tianBreznik/izbrisani/deploy/desk-pi/wscase-ref/wscase-concept-front.png

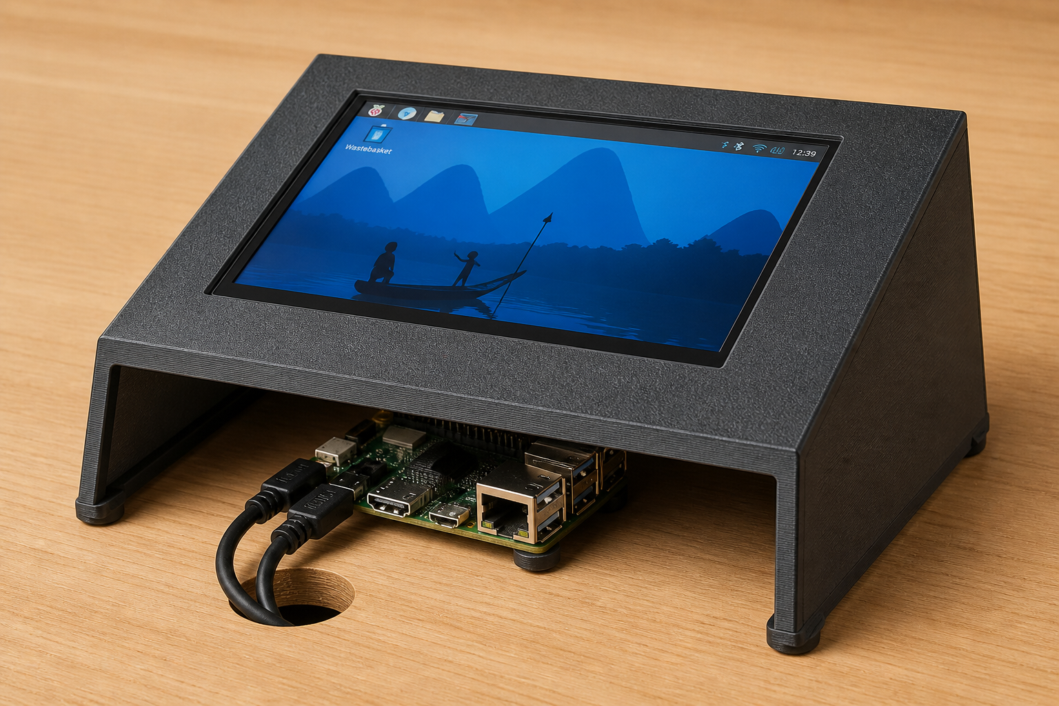
deploy/desk-pi/wscase-ref/wscase-concept-front.png
