tianBreznik/izbrisani/tmp/wscase/ext_measure.png

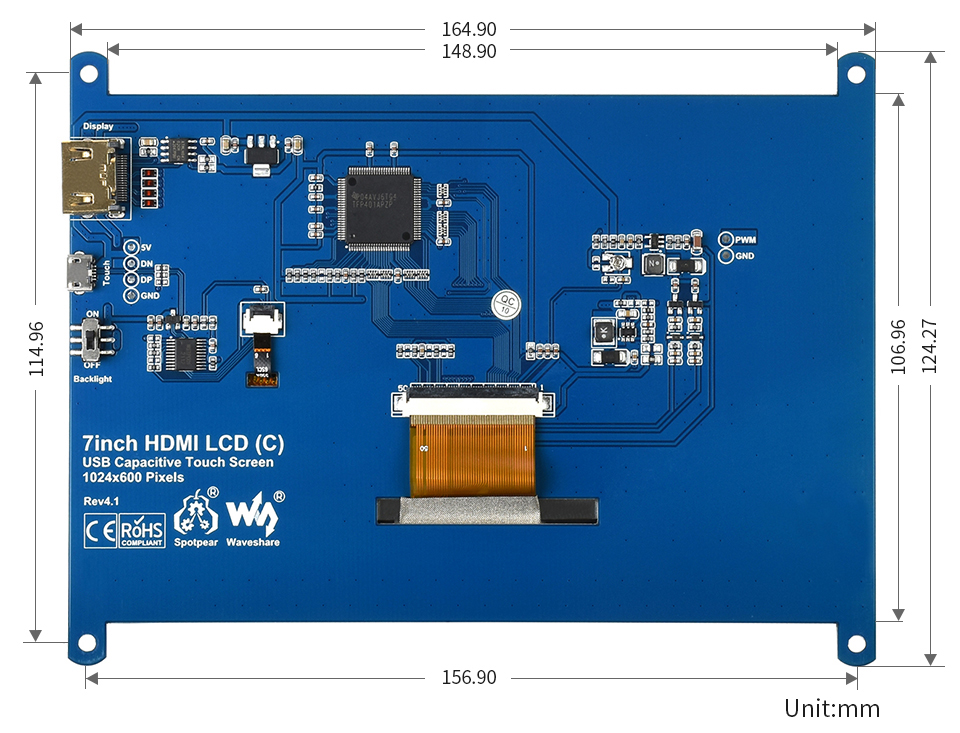
tmp/wscase/ext_measure.png
