tianBreznik/izbrisani/deploy/desk-pi/wscase-ref/wscase-concept-cutaway.png

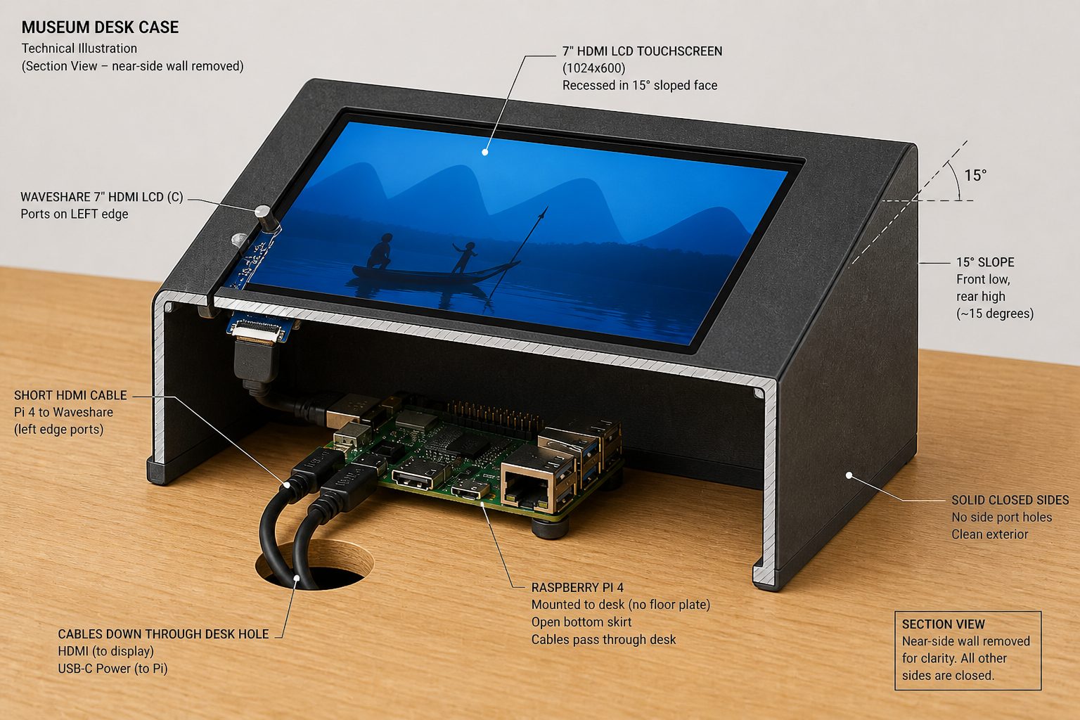
deploy/desk-pi/wscase-ref/wscase-concept-cutaway.png
