tianBreznik/izbrisani/deploy/desk-pi/wscase-ref/wscase-corner-pad-explain.png

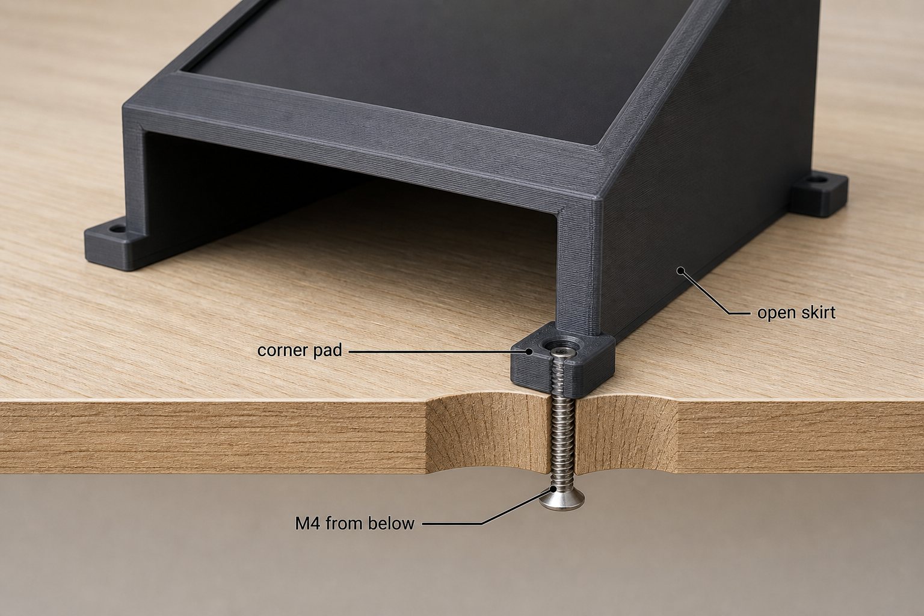
deploy/desk-pi/wscase-ref/wscase-corner-pad-explain.png
