tianBreznik/izbrisani/tmp/wscase/Dimension.png

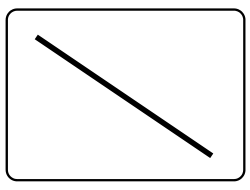
tmp/wscase/Dimension.png
