tianBreznik/izbrisani/tmp/wscase/ext3x_b.png

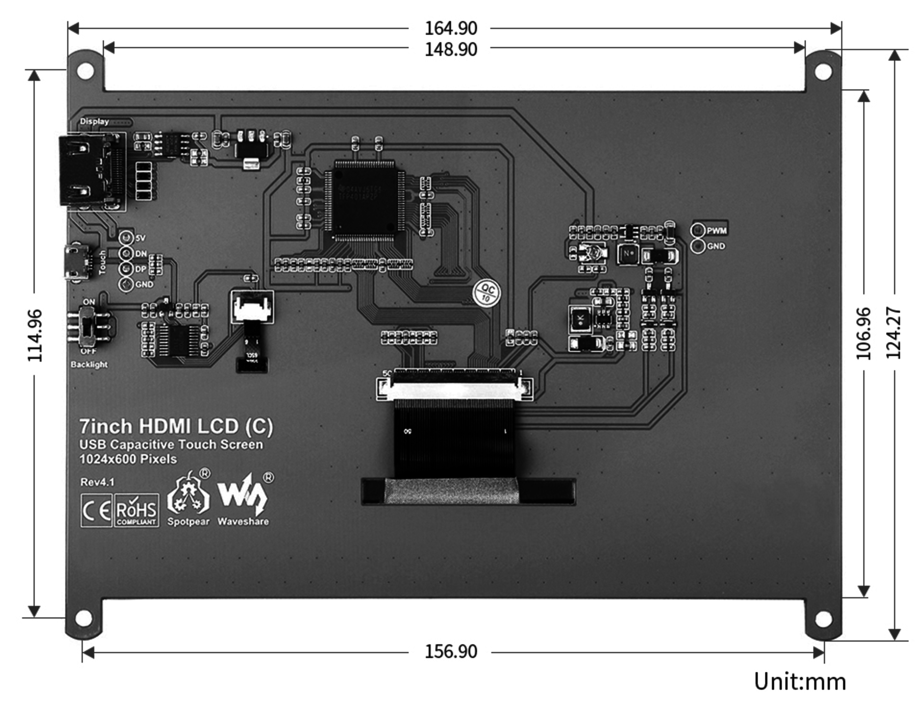
tmp/wscase/ext3x_b.png
