tianBreznik/izbrisani/tmp/wscase/holes_mask.png

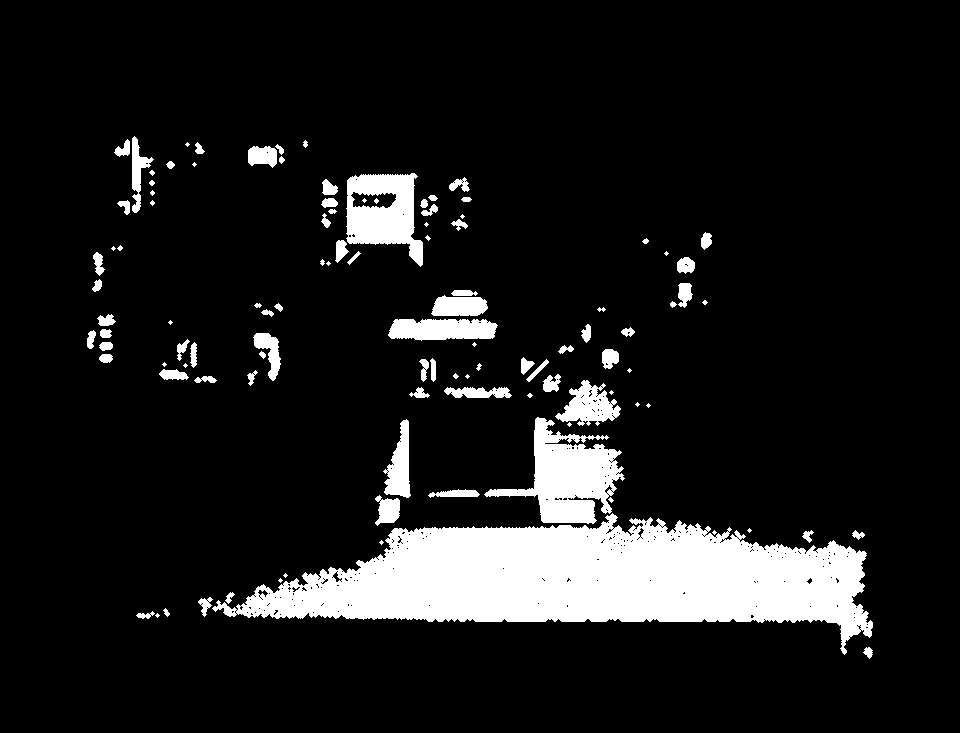
tmp/wscase/holes_mask.png
