tianBreznik/izbrisani/tmp/wscase/Spec.png

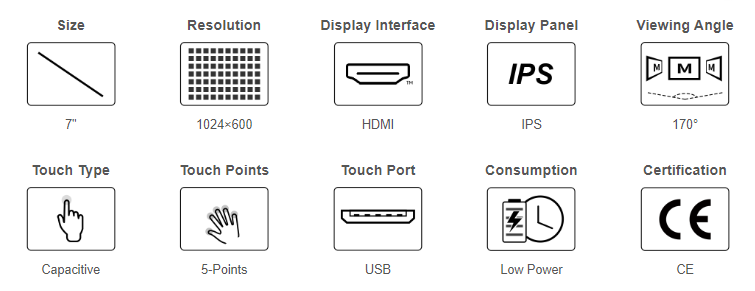
tmp/wscase/Spec.png
