tianBreznik/izbrisani/tmp/wscase/viz_BL.png

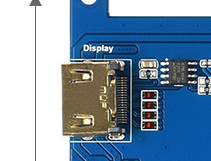
tmp/wscase/viz_BL.png
