tianBreznik/izbrisani/tmp/wscase/viz_BR.png

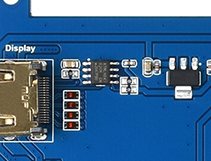
tmp/wscase/viz_BR.png
