tianBreznik/izbrisani/tmp/wscase/viz_TL.png

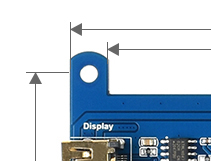
tmp/wscase/viz_TL.png
