tianBreznik/izbrisani/tmp/wscase/viz_TR.png

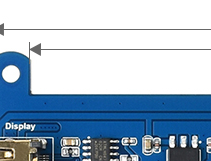
tmp/wscase/viz_TR.png
