tianBreznik/izbrisani/deploy/desk-pi/wscase-ref/7inch-HDMI-LCD-C-1118.stp

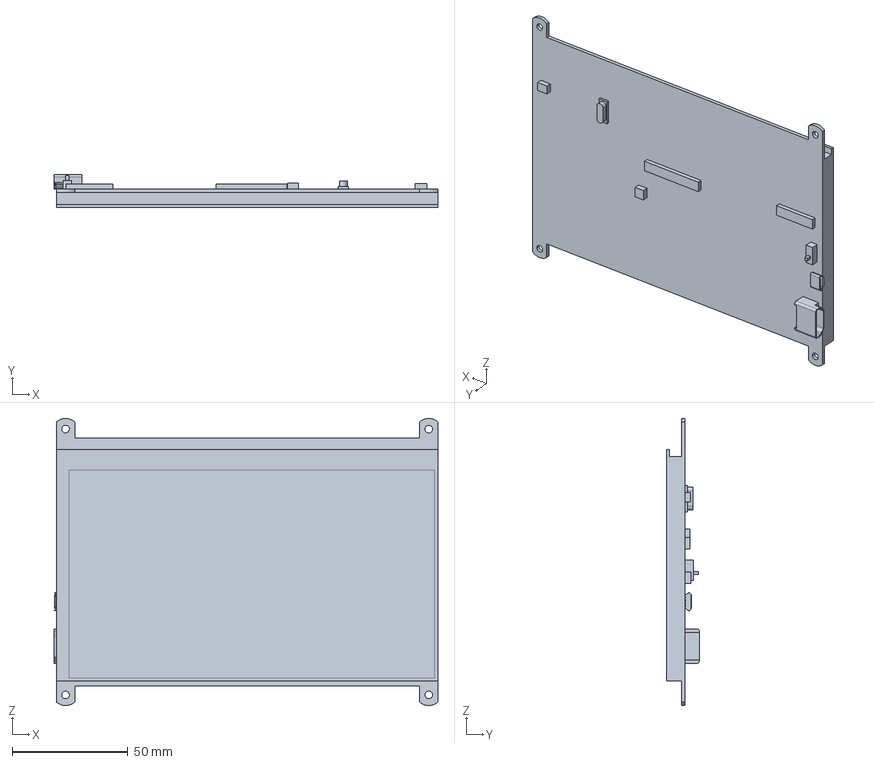
[picture p13: CAD file, 2026-08-29]
deploy/desk-pi/wscase-ref/7inch-HDMI-LCD-C-1118.stp
166.0 x 14.1 x 124.1 mm
