tianBreznik/izbrisani/deploy/desk-pi/wscase/wscase2.stl

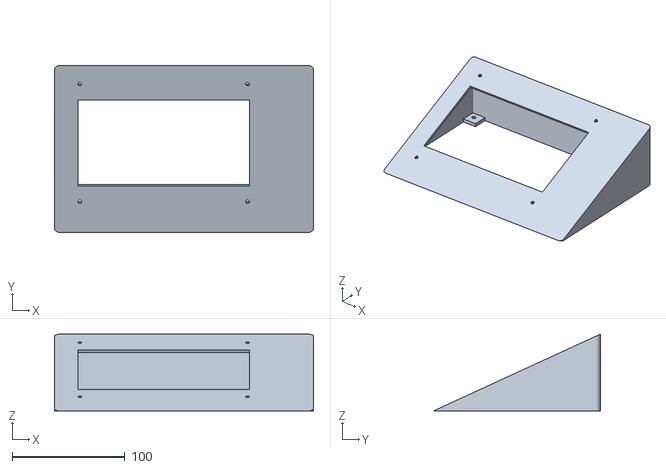
[picture p14: CAD file, 2026-08-29]
deploy/desk-pi/wscase/wscase2.stl
230.0 x 148.0 x 68.1
