tianBreznik/izbrisani/deploy/desk-pi/wscase/hole_gauge.stl

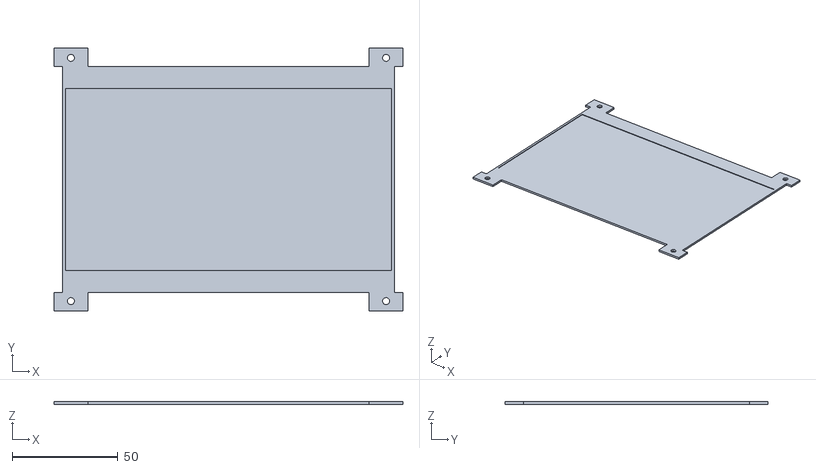
[picture p15: CAD file, 2026-08-29]
deploy/desk-pi/wscase/hole_gauge.stl
164.9 x 124.3 x 1.20
