tianBreznik/izbrisani/tmp/wscase/extract_3_7inch HDMI LCD (B).stp

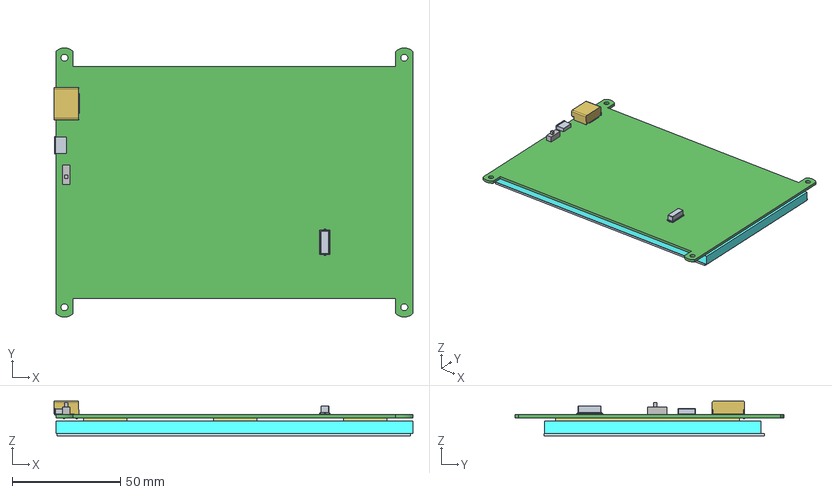
[picture p16: CAD file, 2026-08-29]
tmp/wscase/extract_3_7inch HDMI LCD (B).stp
165.7 x 124.3 x 16.1 mm
PCBA
SWITCH
FOAM x 3
HDMI
JINGZHENS3
USB-CONNECTER
THICK-SCREEN
C-SCREEN
