tianBreznik/izbrisani/(list of files, cad)

Other CAD files:
deploy/desk-pi/wscase/wscase.stl
