tianBreznik/izbrisani/tmp/wscase/b_panel.pdf

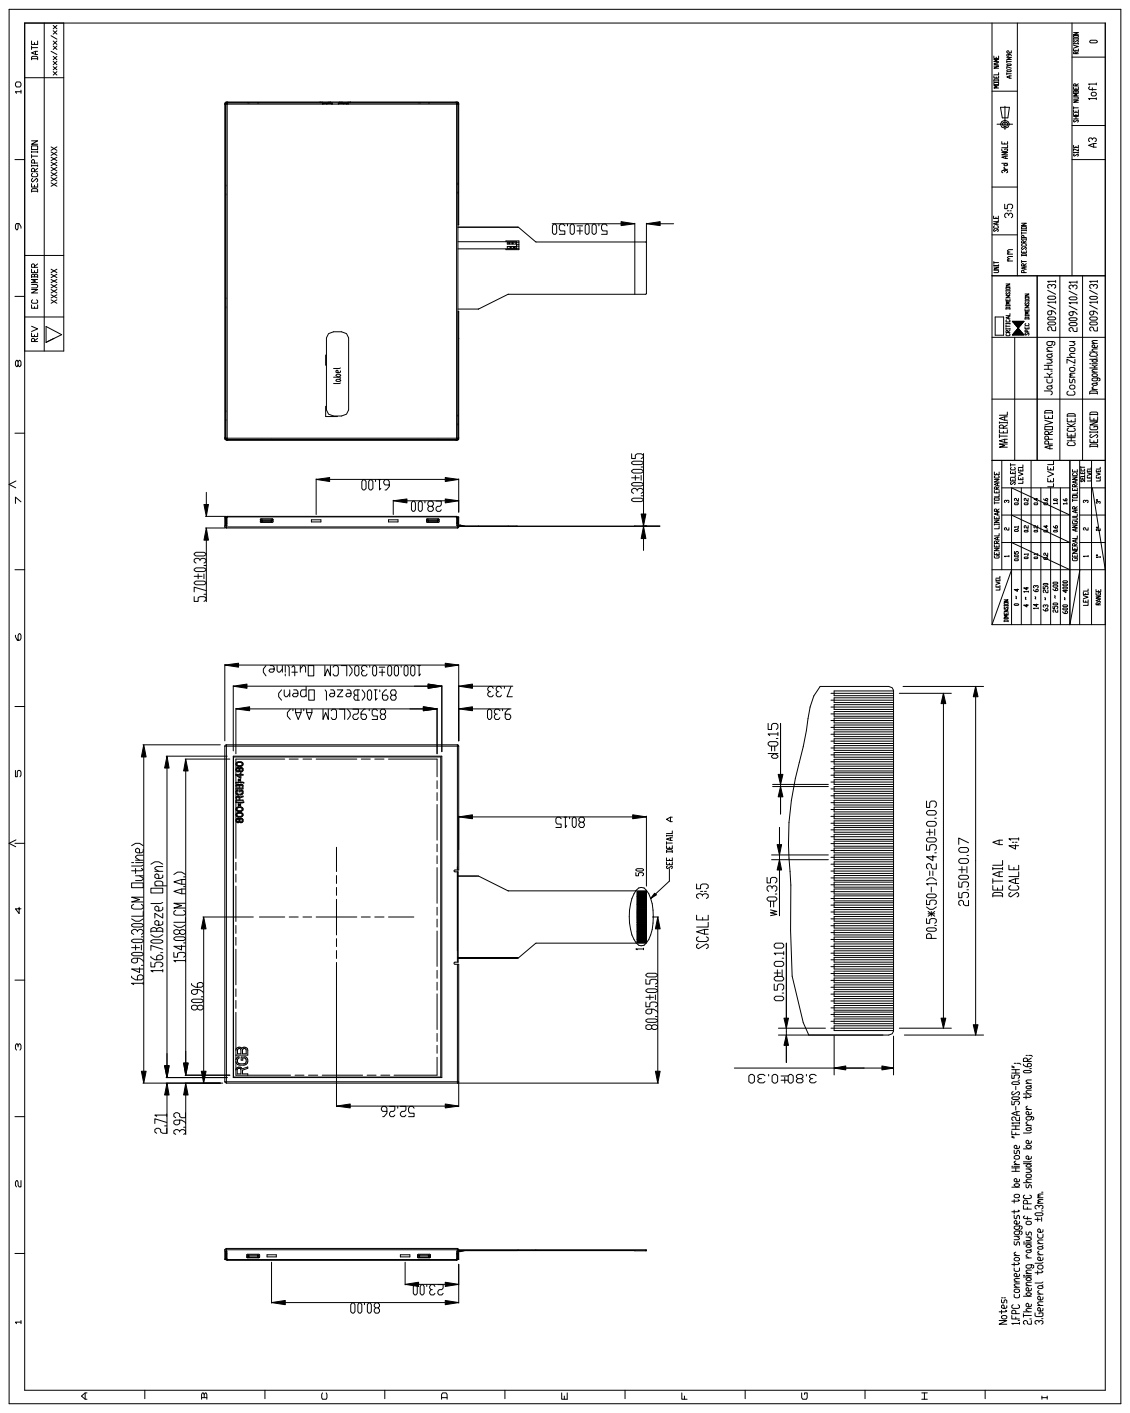
[picture p17: page 1]
