tianBreznik/izbrisani/(commit log)

2026-08-29 pulse node
    [7inch-HDMI-LCD-C-1118.stp, ext_ocr.tsv, extract_3_7inch HDMI LCD (B).stp, extract_6_1118.stp, hole_gauge.stl, wscase.scad, wscase.stl, wscase2.stl]
2026-09-02 pi player recursion fix
    [desk_client.py]
